cjq-sky/amd-fpga-power-quality-release/skill/capture-audit/SKILL.md

---
name: capture-audit
description: 审核实板采集材料的文件完整性、源与Run及参考的对应关系，整理重采替换、旧尝试隔离和人工确认依据。用于数据追溯，不批准物理标签或训练资格。
---

先读 [README.md](README.md)，根据用户现有采集格式选择检查方式。现成capture-registration-0.1目录可运行scripts/check_capture.py；其他格式先按templates中的清单审核，不强改原件以迎合检查器。

将文件完整性与实验身份分开判断；源快照一致不等于外部源清单已复核。每个结论保存证据路径、哈希、审核人及状态。没有现场依据的事项记未知，不能以预测或文件名补造真值。

选定重采必须有明确替换理由和证据。旧尝试保留并隔离，不覆盖、不删除；源、Run、参考应组成明确的选定关系。已有批量声明按覆盖范围关联，不因原表空白重复索取同一确认。稳定同工况声明不能升级为硬件同步。

按 [workflow.md](workflow.md) 输出自动检查结果、人工判断、待答事项和选定/隔离清单。案例见 [references/cases.md](references/cases.md)。只读审核发现的问题不自动触发重采，先判断是否已有可复用证据。
