cjq-sky/amd-fpga-power-quality-release/skill/capture-audit/references/cases.md

# 已完成案例及经验来源

## 80条与旧尝试

项目2026-11-02已审核80条2560帧的交付身份，存在84个Run，最终选定80个，旧尝试另行隔离。依据原项目的文件身份、选定Run及参考核对记录。可复用规则：文件盘点数量与选定Run数量分别统计；重采不能覆盖旧记录。

## 第44条错配闭环

历史观察：文件存在、哈希一致与Raw完整不足以排除工况源身份错配。最终选定44号_002与44_repeat0参考。可复用规则：源身份、Run和参考三方分别核对；记录替换理由，旧尝试继续隔离。本包MISMATCH仅演示登记与源快照冲突，不声称自动重现或识别真实44号的所有故障。

## 批量现场事实确认

依据原项目的文件身份、选定Run及参考核对记录。操作者已批量确认同节点、设置保持、processed16时STOP及换工况前保存参考；原CSV确认格仍为空是因为保留原表。可复用规则：原表与补充声明通过索引关联，避免按空白重复追问。该证据支持稳定同工况关联，不证明共时钟或覆盖全部32帧。

上述历史材料保留在原项目；本包提供归纳与来源文件哈希，不捆绑完整采集原件。陌生队伍可以运行软件样例并套用模板，不能在缺少原项目证据时独立复验80条历史结论。
