cjq-sky/amd-fpga-power-quality-release/skill/model-handoff/references/initial_board_review.md

# 早期板端模型接入记录摘要

记录日期2026-11-02，属于正常正弦接入阶段；不是现用整机的未完成事项清单。当前状态见[版本范围](version_scope.md)。本页为既有结果摘要。

## 当时已记录结果

- Python3.10.4 ARMv7环境，physical-portable-1.1的LR/RF各2496行黄金回放类别差异0，概率差小于1e-6。
- 正常正弦两轮各34次处理，其中2次隔离、32次有效；保存输入数值复核一致，LR最大概率差3.33e-16、RF为0。
- 原Raw关联保留RAW_VALID_FEATURE_UNMATCHED，不由帧号相等提升为运行时MATCHED。
- LR/RF调用中位耗时0.568859/5.708852ms，整轮处理中位153.466963/160.733966ms；离线黄金验证进程峰值RSS14.5039MiB，仅属于该离线进程。

当时CLEAN输入H1观察工作点超出原训练批次范围，因此该记录支持工程调用，不自动授予新输入物理标签。模拟包装层检查与真实Reader运行分别记录。

早期文档中“仅正弦通过、污染工况/HDMI待做”的描述只属于当时。后续四工况、EV26及现用125MHz模型/HDMI接入均已有对应成果，不再沿用这些旧待办。历史结果不额外证明端到端时延、服务内存上限或跨设备泛化。
