cjq-sky/amd-fpga-power-quality-release/skill/model-handoff/references/version_scope.md

# 版本及验证范围

本页用于区分技能包的历史记录、v1.1新增能力与现用整机状态，不发起新的实验。

|层次|已有记录|应如何解读|
|---|---|---|
|早期正弦接入，2026-11-02|ARMv7标准库黄金回放、正常正弦真实单Reader调用|只说明当时这批记录的范围；其“后续四工况/HDMI待做”事项已经属于历史阶段|
|随后四工况接入，2026-11-02|两算法共8轮、256有效帧及4个启动隔离拒绝|已知工况链路及数值一致性；不是独立四分类准确率|
|技能model-handoff v1.1|EV26，12Run/384保存输入，LR321/384、RF292/384；同输入计分与失败分母检查|保存案例成对计分，案例已用于选模，不作为独立泛化测试|
|现用125MHz系统，2026-11-03|板端模型、双通道事件、HDMI自动刷新/触摸与PC共享显示已完成接入|现用系统状态；不能由早期记录中的待办反推当前功能缺失|

v1.1范围包含黄金回放比对与保存结果成对计分；技能算法不认证跨设备泛化、标签资格或整机实时指标。原deployment_manifest中的TRAINING_ONLY及导出时board_verified=false是冻结身份，保持原样。早期记录中的性能数字也只属于当时运行条件。

本目录initial_board_review和four_condition_review给出对应日期的技术结论与测量口径。工作流提供可复用任务模板。
