cjq-sky/amd-fpga-power-quality-release/docs/reproducibility/ad7606_wiring.csv

signal | adc_j5_pin | pynq_rpi_physical_pin | fpga_package_pin | project_port | direction
DB0 | J5-17 | 24 | F19 | ad_data[0] | adc_to_pynq
DB1 | J5-18 | 21 | V10 | ad_data[1] | adc_to_pynq
DB2 | J5-15 | 19 | V8 | ad_data[2] | adc_to_pynq
DB3 | J5-16 | 23 | W10 | ad_data[3] | adc_to_pynq
DB4 | J5-13 | 32 | B20 | ad_data[4] | adc_to_pynq
DB5 | J5-14 | 33 | W8 | ad_data[5] | adc_to_pynq
DB6 | J5-11 | 8 | V6 | ad_data[6] | adc_to_pynq
DB7 | J5-12 | 10 | Y6 | ad_data[7] | adc_to_pynq
DB8 | J5-9 | 36 | B19 | ad_data[8] | adc_to_pynq
DB9 | J5-10 | 11 | U7 | ad_data[9] | adc_to_pynq
DB10 | J5-7 | 12 | C20 | ad_data[10] | adc_to_pynq
DB11 | J5-8 | 35 | Y8 | ad_data[11] | adc_to_pynq
DB12 | J5-5 | 38 | A20 | ad_data[12] | adc_to_pynq
DB13 | J5-6 | 40 | Y9 | ad_data[13] | adc_to_pynq
DB14 | J5-3 | 15 | U8 | ad_data[14] | adc_to_pynq
DB15 | J5-4 | 16 | W6 | ad_data[15] | adc_to_pynq
BUSY | J5-19 | 18 | Y7 | ad_busy | adc_to_pynq
FRSTDATA | J5-20 | 22 | F20 | ad_frstdata | adc_to_pynq
CONVST_A | J5-26 | 37 | W9 | ad_convst | pynq_to_adc
CONVST_B | J5-23 | 37 | W9 | ad_convst | pynq_to_adc
RESET | J5-24 | 7 | Y18 | ad_reset | pynq_to_adc
CS_N | J5-22 | 29 | Y19 | ad_cs_n | pynq_to_adc
RD_SCLK | J5-21 | 31 | U18 | ad_rd_n | pynq_to_adc
GND | J5-32 | 6 |  |  | common_ground
