cjq-sky/amd-fpga-power-quality-release/sim/results/config_precompute.txt

PASS RESET_BOUNDARIES single_edge=1 partial_W=1 held_B=1 retained_prior=1
PASS PUBLIC_EQUIV samples=17729 outputs=28 pair_cases=60 XZ_base=256 XZ_generation=8
PASS CONTRACT sessions=361 checked=361 commits=2084 min_gap=3 stale_three_stage=61
